JonasMerrell/simplecore/renders/enclosure-closed.png

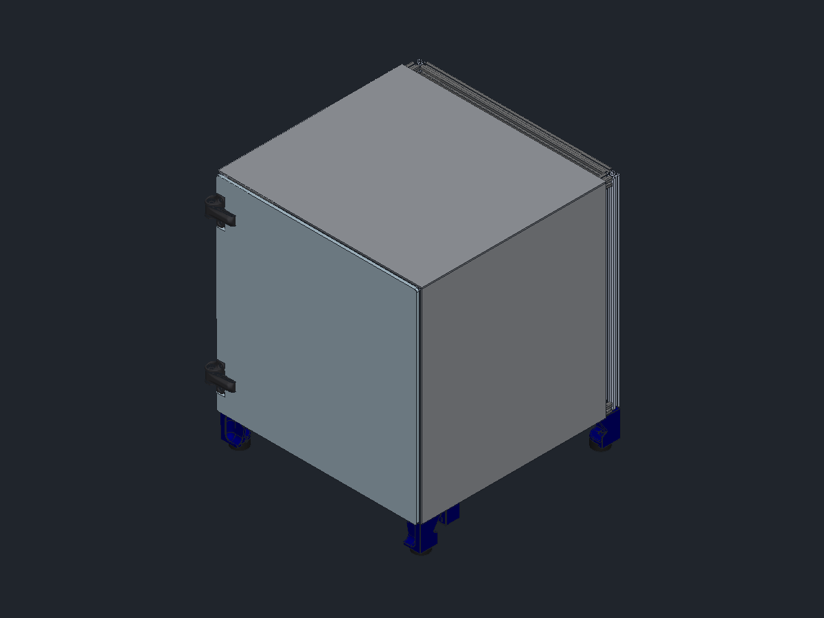
renders/enclosure-closed.png
