JonasMerrell/simplecore/renders/enclosure-door-open.png

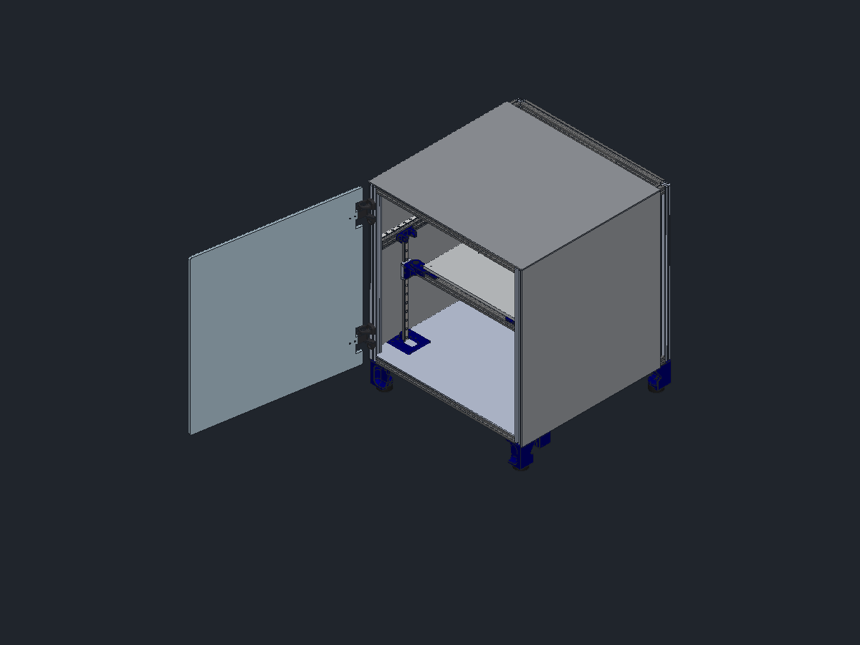
renders/enclosure-door-open.png
