JonasMerrell/simplecore/renders/enclosure-hinge.png

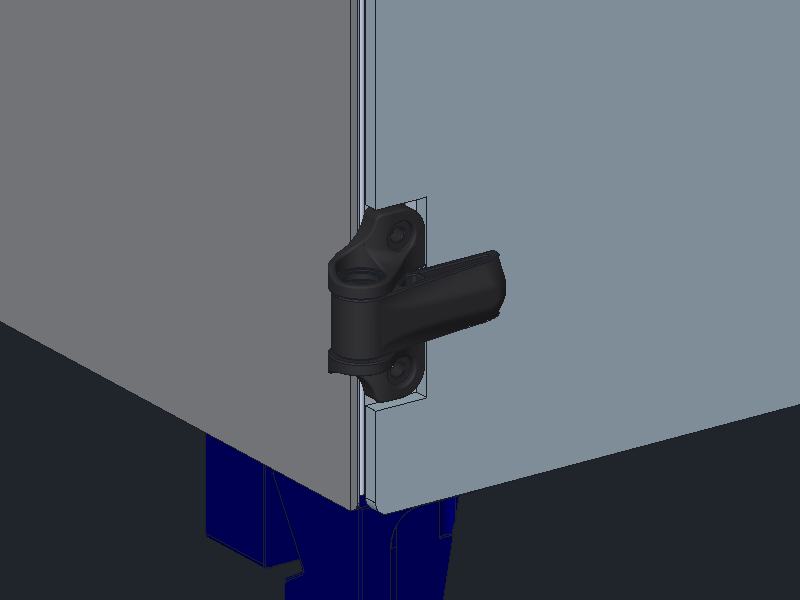
renders/enclosure-hinge.png
