JonasMerrell/simplecore/k3-hinge/k3_front_door_bearing_block_2.stl

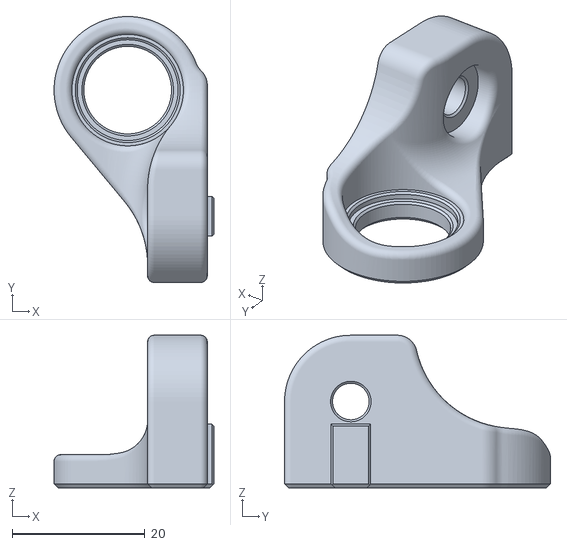
[picture p4: CAD file, 2026-11-11]
k3-hinge/k3_front_door_bearing_block_2.stl
24.1 x 40.1 x 23.0
