JonasMerrell/simplecore/step/Carriage fan plate (Part 3).step

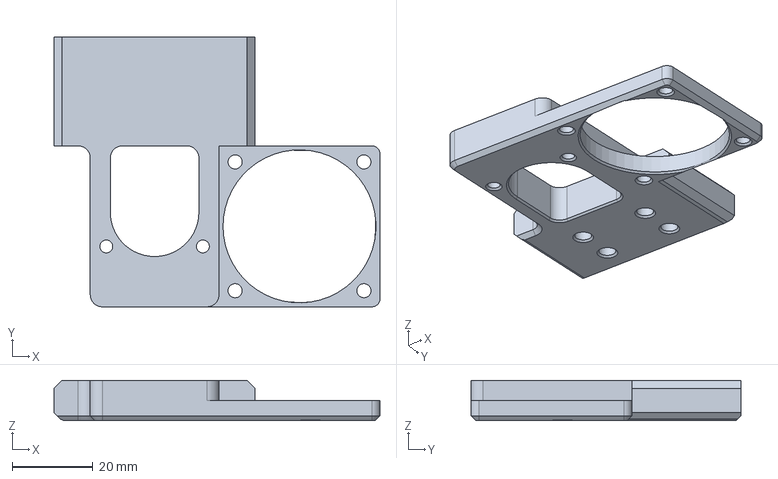
[picture p5: CAD file, 2026-11-08]
step/Carriage fan plate (Part 3).step
81.0 x 67.0 x 10.0 mm
