JonasMerrell/simplecore/k3-hinge/k3_front_door_arm.stl

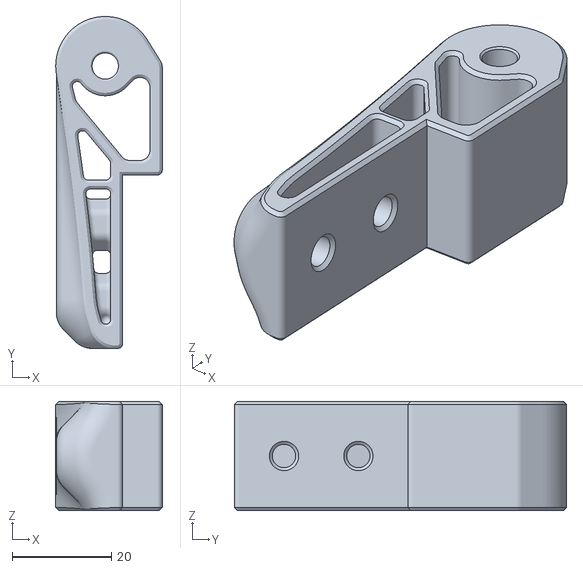
[picture p6: CAD file, 2026-11-11]
k3-hinge/k3_front_door_arm.stl
21.5 x 67.0 x 22.0
