JonasMerrell/simplecore/step/Belt clamp (Part 7).step

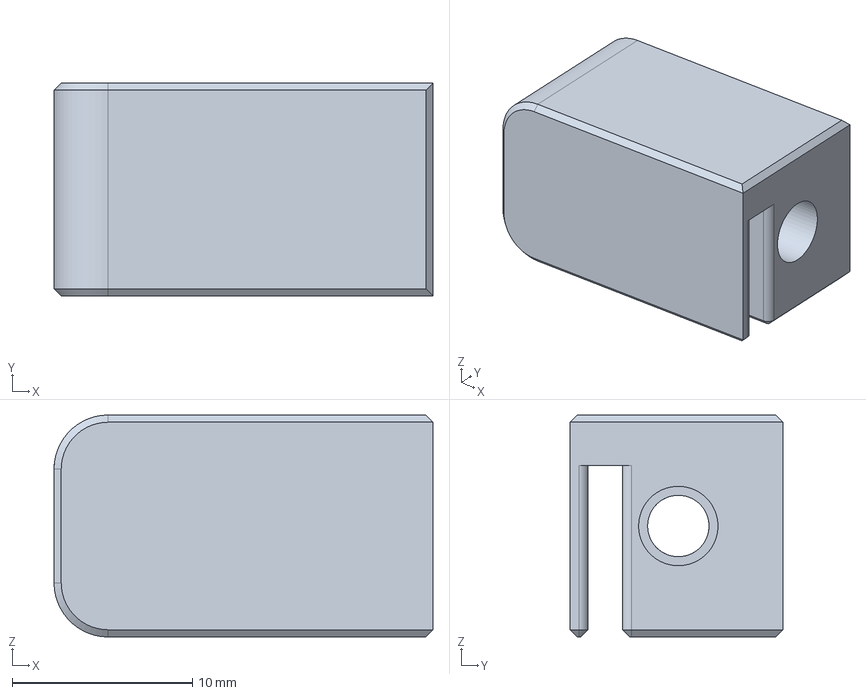
[picture p7: CAD file, 2026-11-08]
step/Belt clamp (Part 7).step
21.0 x 11.8 x 12.3 mm
