JonasMerrell/simplecore/step/Part cooling duct (Part 10).step

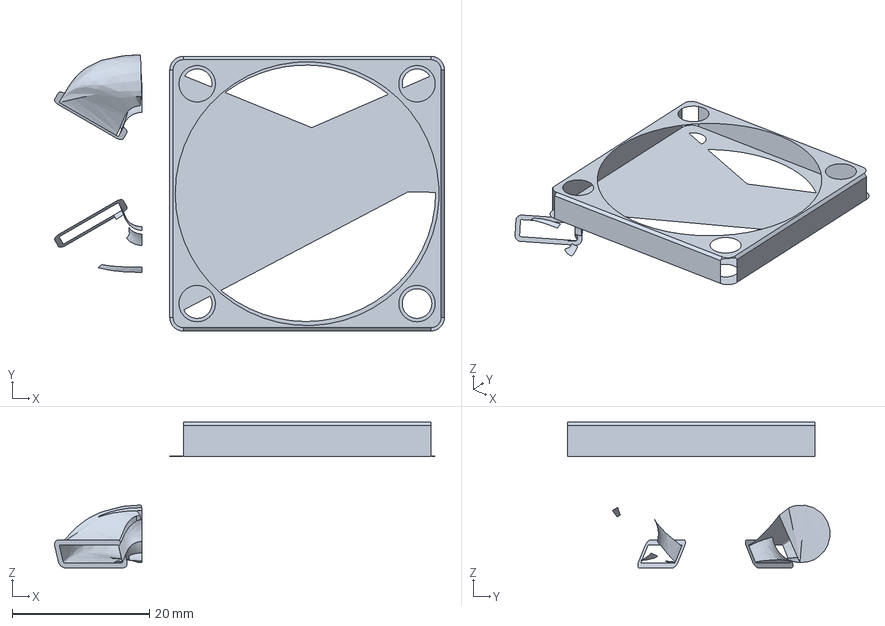
[picture p8: CAD file, 2026-11-08]
step/Part cooling duct (Part 10).step
56.8 x 40.2 x 21.2 mm
