JonasMerrell/simplecore/step/1 inch tube (X beam).step

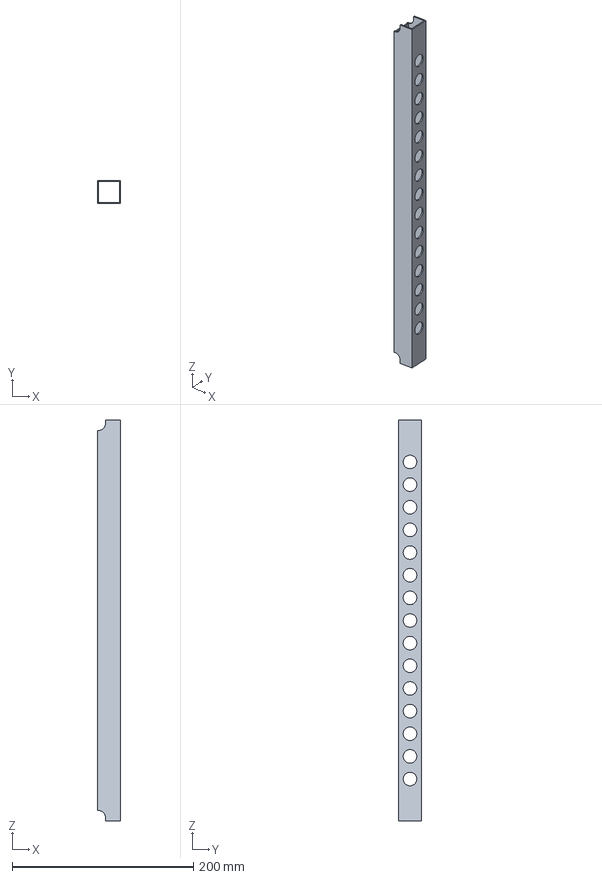
[picture p9: CAD file, 2026-11-08]
step/1 inch tube (X beam).step
25.9 x 25.9 x 442.6 mm
