JonasMerrell/simplecore/step/Front gantry end cap (Part 2).step

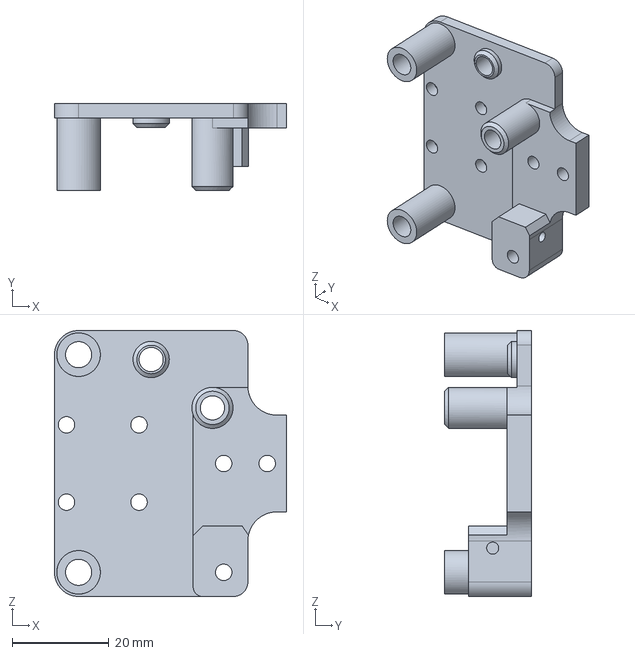
[picture p10: CAD file, 2026-11-08]
step/Front gantry end cap (Part 2).step
48.0 x 17.9 x 55.0 mm
