JonasMerrell/simplecore/step/Probe mount (Part 6).step

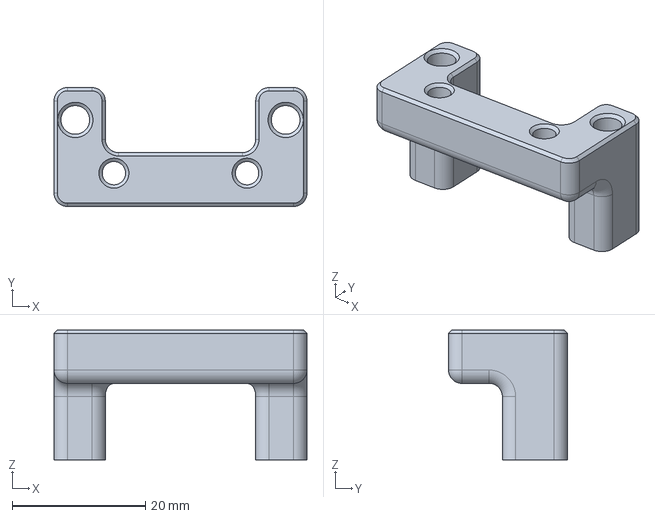
[picture p11: CAD file, 2026-11-08]
step/Probe mount (Part 6).step
38.0 x 17.9 x 19.5 mm
