JonasMerrell/simplecore/step/Belt clamp plate (Part 4).step

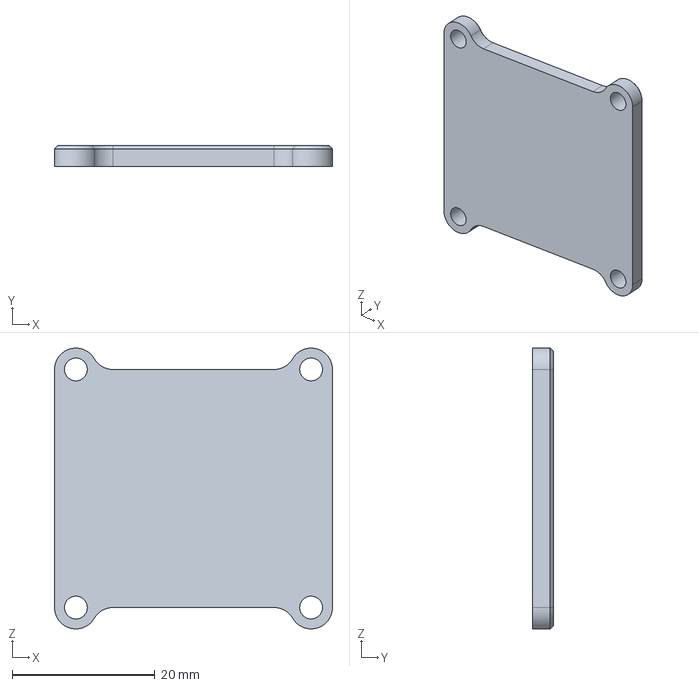
[picture p12: CAD file, 2026-11-08]
step/Belt clamp plate (Part 4).step
39.0 x 3.00 x 39.4 mm
