JonasMerrell/simplecore/step/AWD motor idler V2 (rear).step

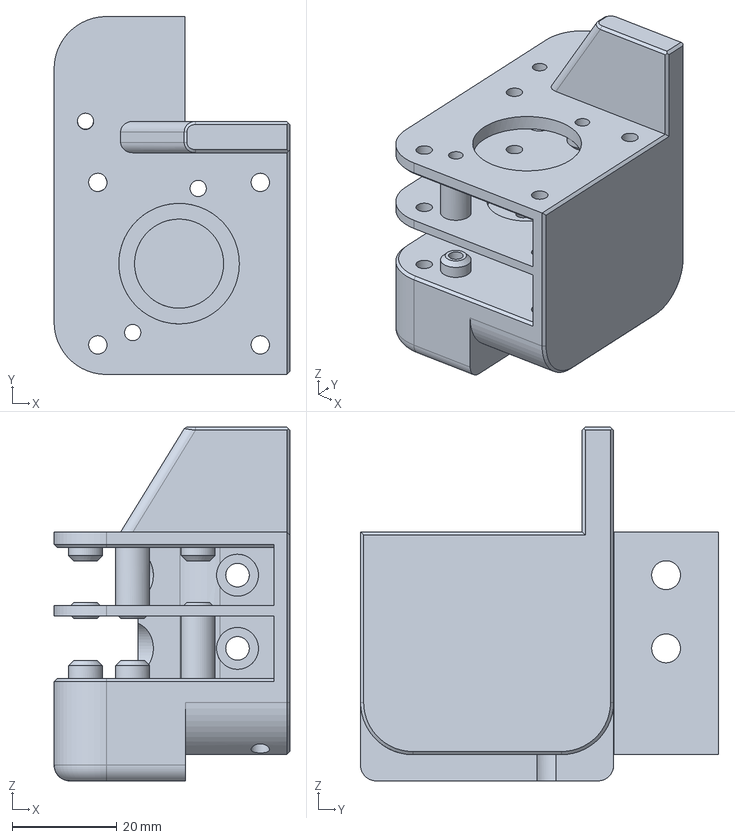
[picture p13: CAD file, 2026-11-08]
step/AWD motor idler V2 (rear).step
45.0 x 68.3 x 67.5 mm
