JonasMerrell/simplecore/step/Rear gantry end (Part 1).step

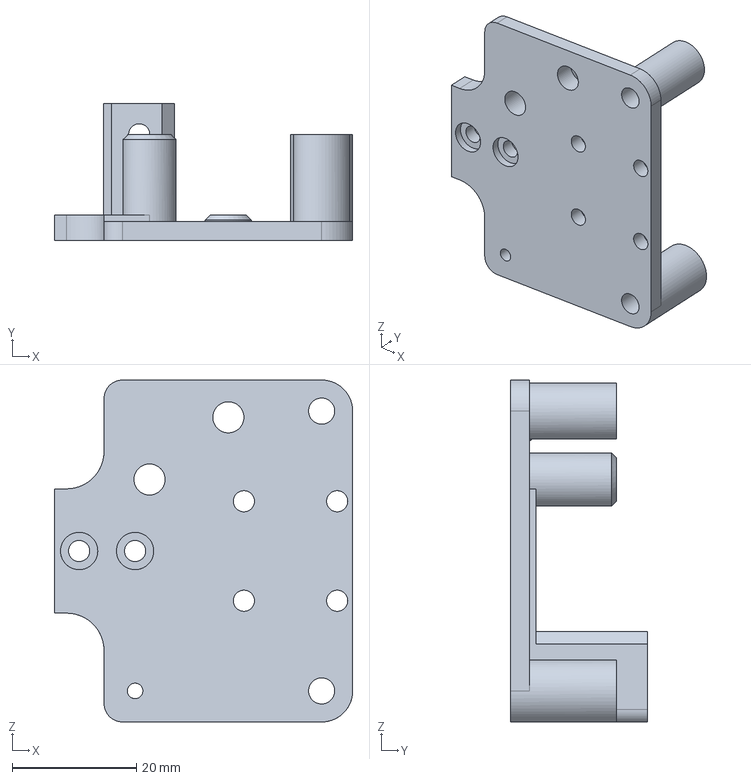
[picture p14: CAD file, 2026-11-08]
step/Rear gantry end (Part 1).step
48.0 x 22.0 x 55.0 mm
