JonasMerrell/simplecore/step/Carriage top plate (Part 1).step

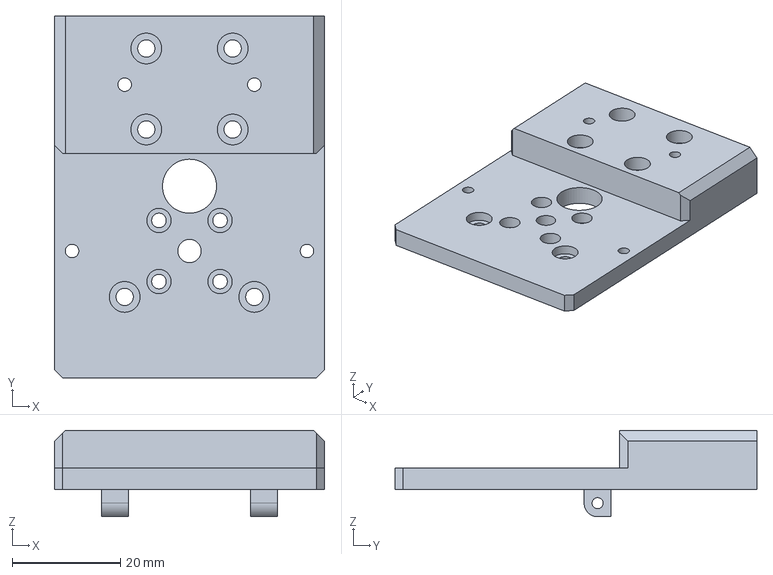
[picture p15: CAD file, 2026-11-08]
step/Carriage top plate (Part 1).step
50.0 x 67.0 x 16.0 mm
