JonasMerrell/simplecore/step/Belt clamp block (Part 5).step

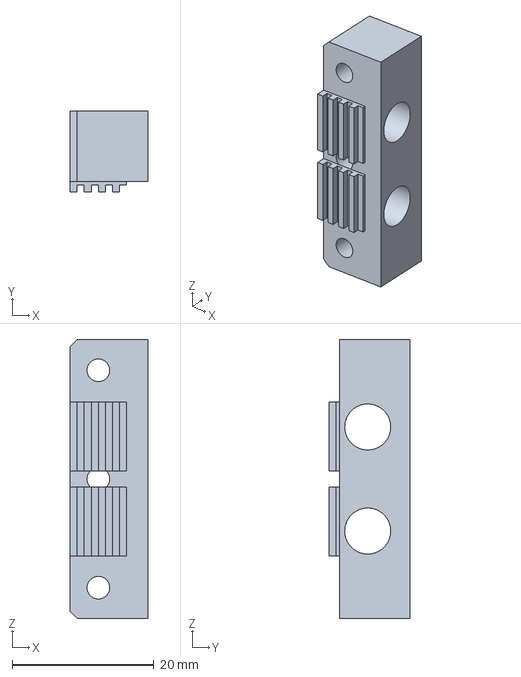
[picture p16: CAD file, 2026-11-08]
step/Belt clamp block (Part 5).step
11.0 x 11.5 x 39.4 mm
