JonasMerrell/simplecore/step/Carriage side plate (Part 2).step

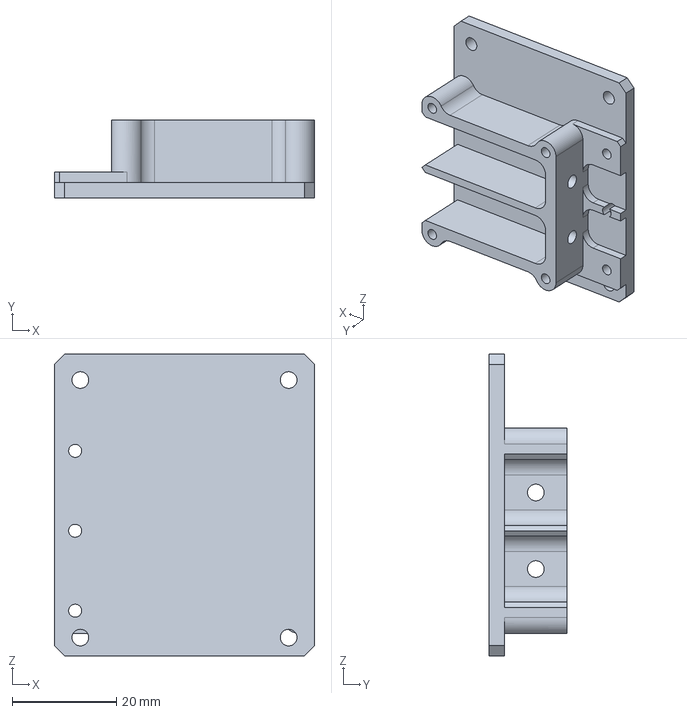
[picture p17: CAD file, 2026-11-08]
step/Carriage side plate (Part 2).step
50.0 x 15.0 x 58.0 mm
