JonasMerrell/simplecore/step/Cable chain mount.step

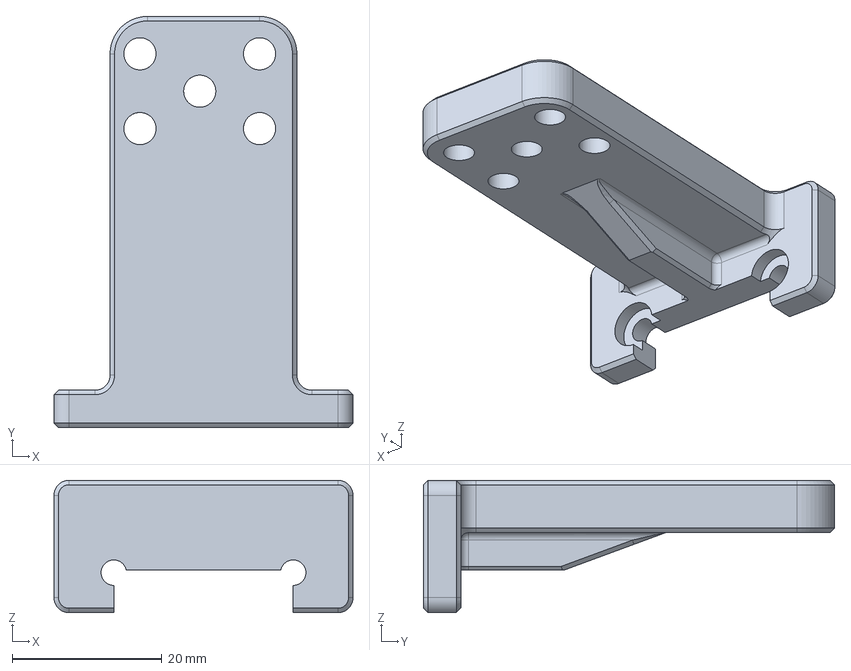
[picture p18: CAD file, 2026-11-08]
step/Cable chain mount.step
40.0 x 55.0 x 17.7 mm
