JonasMerrell/simplecore/step/3010 fan mount (Part 6).step

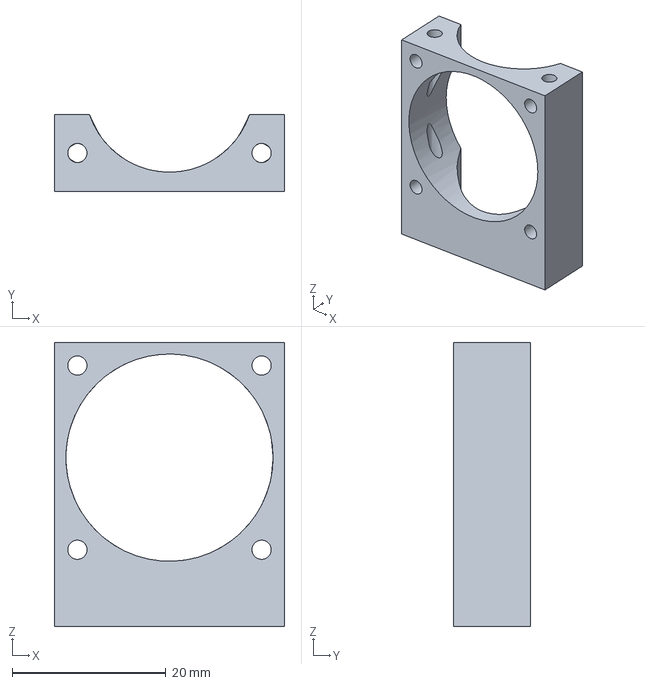
[picture p19: CAD file, 2026-11-08]
step/3010 fan mount (Part 6).step
30.0 x 10.0 x 37.0 mm
