JonasMerrell/simplecore/step/Bent bracket (Part 1).step

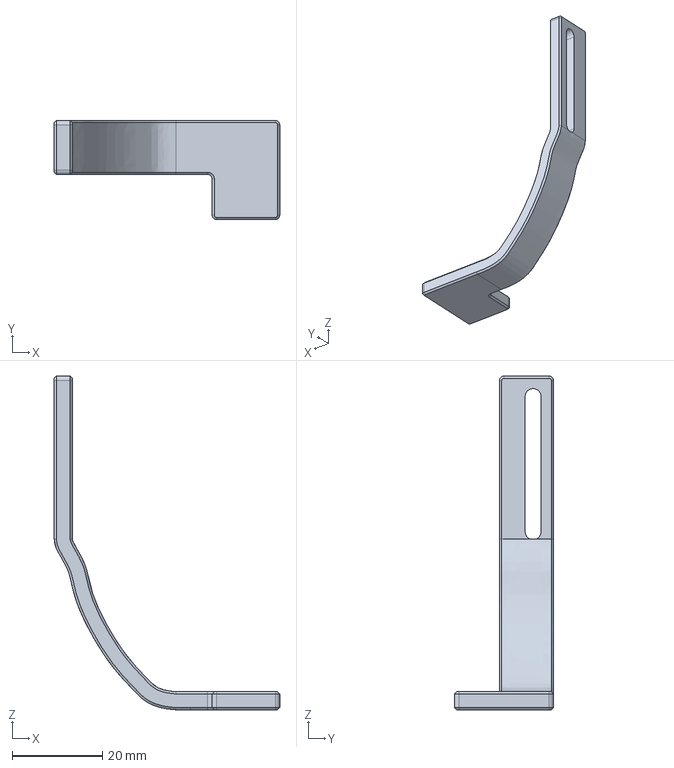
[picture p20: CAD file, 2026-11-08]
step/Bent bracket (Part 1).step
50.0 x 22.0 x 74.0 mm
