JonasMerrell/simplecore/step/Front gantry end (Part 1).step

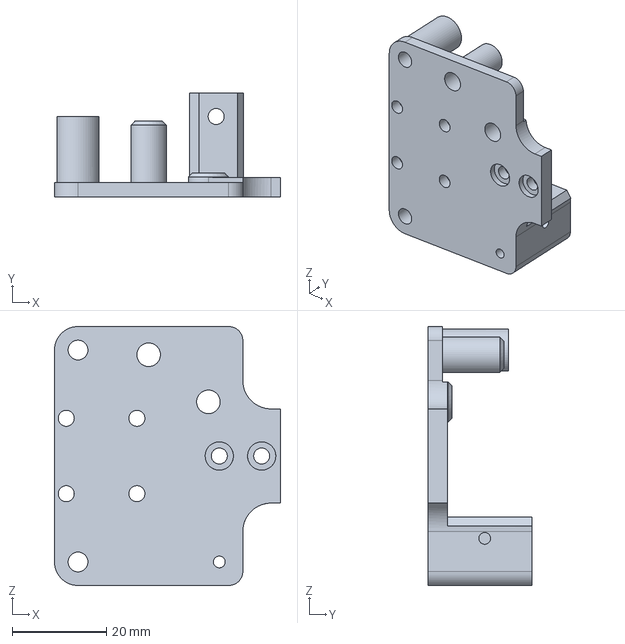
[picture p21: CAD file, 2026-11-08]
step/Front gantry end (Part 1).step
48.0 x 22.0 x 55.0 mm
