JonasMerrell/simplecore/(list of files, cad)

Other CAD files:
k3-hinge/k3_front_door_bearing_block_1.stl
step/AWD motor idler V2 (front).step
step/Rear gantry end cap (Part 2).step
step/Belt clamp (Part 8).step
source/x-carriage-assembly.x_t
