JonasMerrell/simplecore/(commit log)

2026-11-08 X-carriage from the Onshape Parasolid export
    Part Studios per printed part, the mirrored Onshape assemblies and the
    Printer assembly with X, Y and Z slider mates and travel limits.
    Claude-Session: https://claude.ai/code/session_01M2WaHC8TyczfLXAKNBhqE8
    [1 inch tube (X beam).step, 3010 fan mount (Part 6).step, AWD motor idler V2 (front).step, AWD motor idler V2 (rear).step, Belt clamp (Part 7).step, Belt clamp (Part 8).step, Belt clamp block (Part 5).step, Belt clamp plate (Part 4).step]
2026-11-11 Spinning parts and the CoreXY drive
    Revolute mates for the 3010 impeller, the Sherpa drive shaft and idler gear
    (geared together) and the gantry GT2 idlers; two NEMA 17 motors on the AWD
    mounts with belt relations to X and Y.
    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
2026-11-11 Enclosure and front door
    Enclosure panels, the Annex K3 door hinge and a hinged front door in the
    Printer assembly. X-carriage-no-belts.json is the same document without the
    belt relations, for rCAD builds before the belt relation.
    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
    [k3_front_door_arm.stl, k3_front_door_bearing_block_1.stl, k3_front_door_bearing_block_2.stl]
2026-11-11 PIR insulation and chamber heater
    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
